jawedhakimi/Hiking_trailer/Mech/Wall mount v3.step

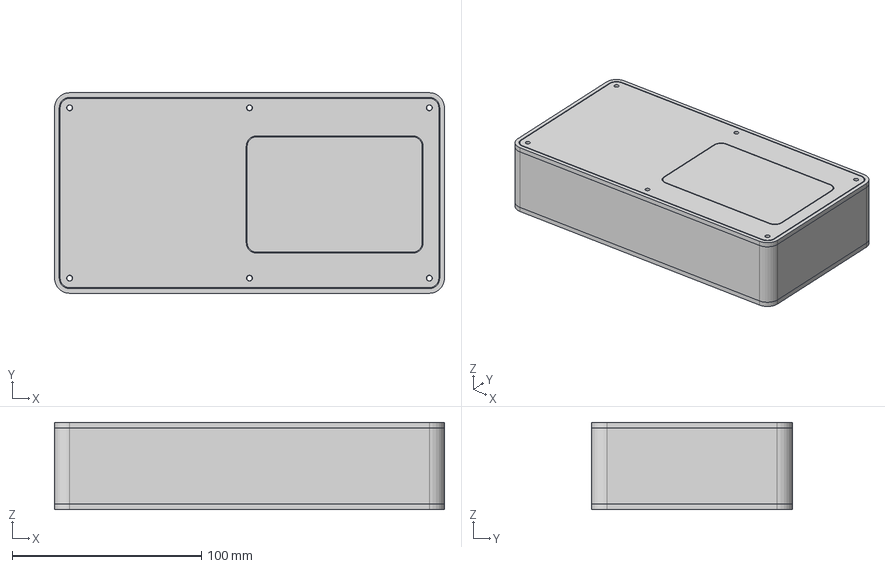
[picture p1: CAD file, 2026-08-29]
Mech/Wall mount v3.step
206.0 x 106.0 x 46.0 mm
3.5inch waveshare display
R_1206 x 4
SOT-223-3_L6.5-W3.4-P2.30-LS7.0-BR
C_0805 x 8
R_0402 x 29
C_0603 x 9
C_1206 x 4
D_SMC
C_0402 x 40
SMAF_L3.5-W2.6-LS4.7-RD
TS-1088-AR02016 x 2
PinHeader_1x03_P2.54mm_Vertical
SM06B-GHS-TB(LF)(SN)--3DModel-STEP-56544 x 3
JST_GH_BM14B-GHS-TBT_1x14-1MP_P1.25mm_Vertical x 2
D_0603 x 5
DFN1006-2L-RD x 4
Q_SOT-23 x 4
ESP32-S3-WROOM-1
SOIC-8_3.9x4.9mm_P1.27mm x 7
SOT-23-3_L2.9-W1.3-P1.90-LS2.4-BL-1
R4875G1_ESP32S3_CAN_Controller 1.80
TYPE-C-SMD_HX-TYPE-C-16PIN
BM08B-GHS-TBT-LF--SN--N---3DModel-STEP-56544 x 2
R4875G1_ESP32S3_CAN_Controller_PCB
Wall mount_1
Face plate
