jawedhakimi/Hiking_trailer/Mech/Face plate.step

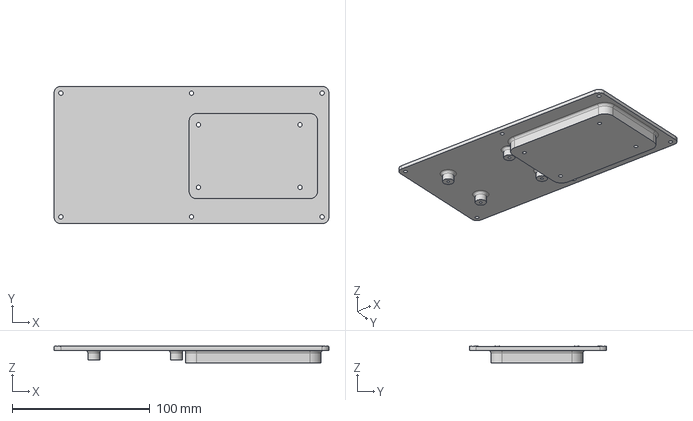
[picture p3: CAD file, 2026-08-29]
Mech/Face plate.step
200.0 x 100.0 x 12.0 mm
