jawedhakimi/Hiking_trailer/Mech/3.5inch waveshare display v4.step

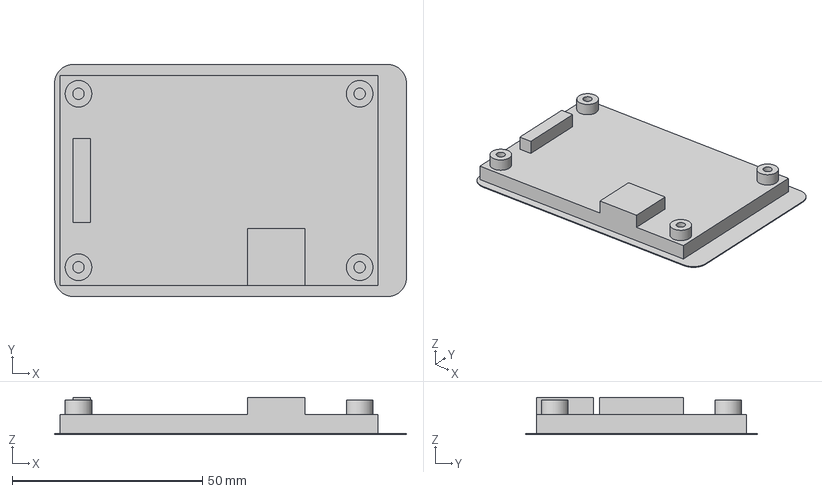
[picture p4: CAD file, 2026-08-29]
Mech/3.5inch waveshare display v4.step
92.4 x 61.0 x 9.80 mm
