jawedhakimi/Hiking_trailer/Mech/Wall mount v2.step

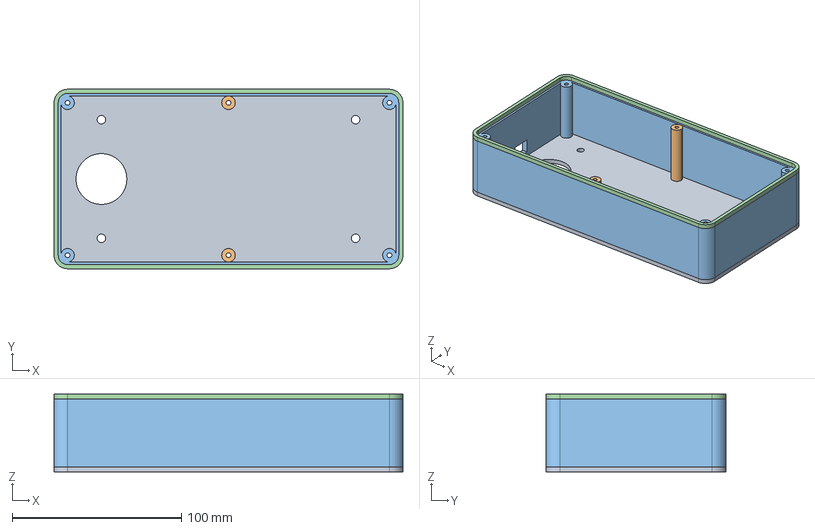
[picture p5: CAD file, 2026-08-29, an earlier design]
Mech/Wall mount v2.step
206.0 x 106.0 x 46.0 mm
