jawedhakimi/Hiking_trailer/HW/ESP32_VESC_Controller.pdf

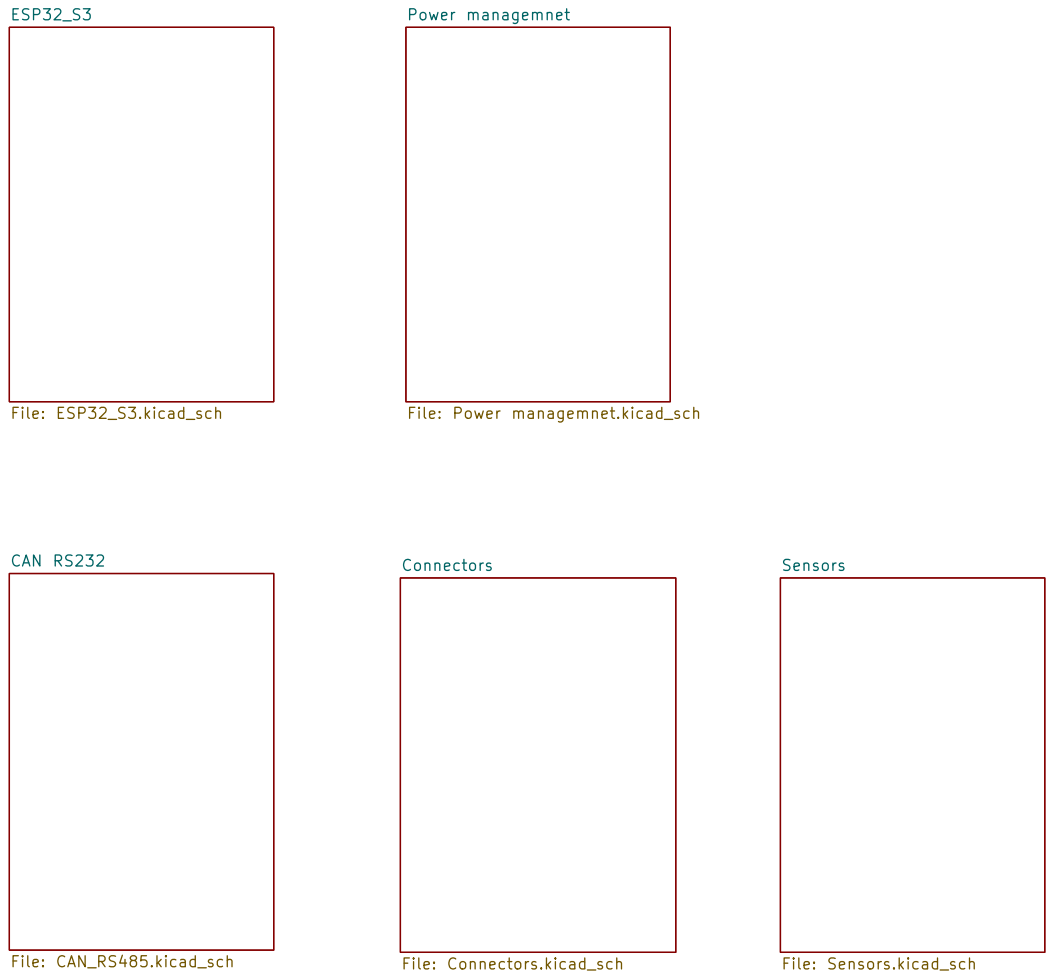
[picture p6: page 1]

Power managemnet File: Power managemnet.kicad_sch

Size: A4 | Rev:
KiCad E.D.A. 10.0.3 | Id: 1/6

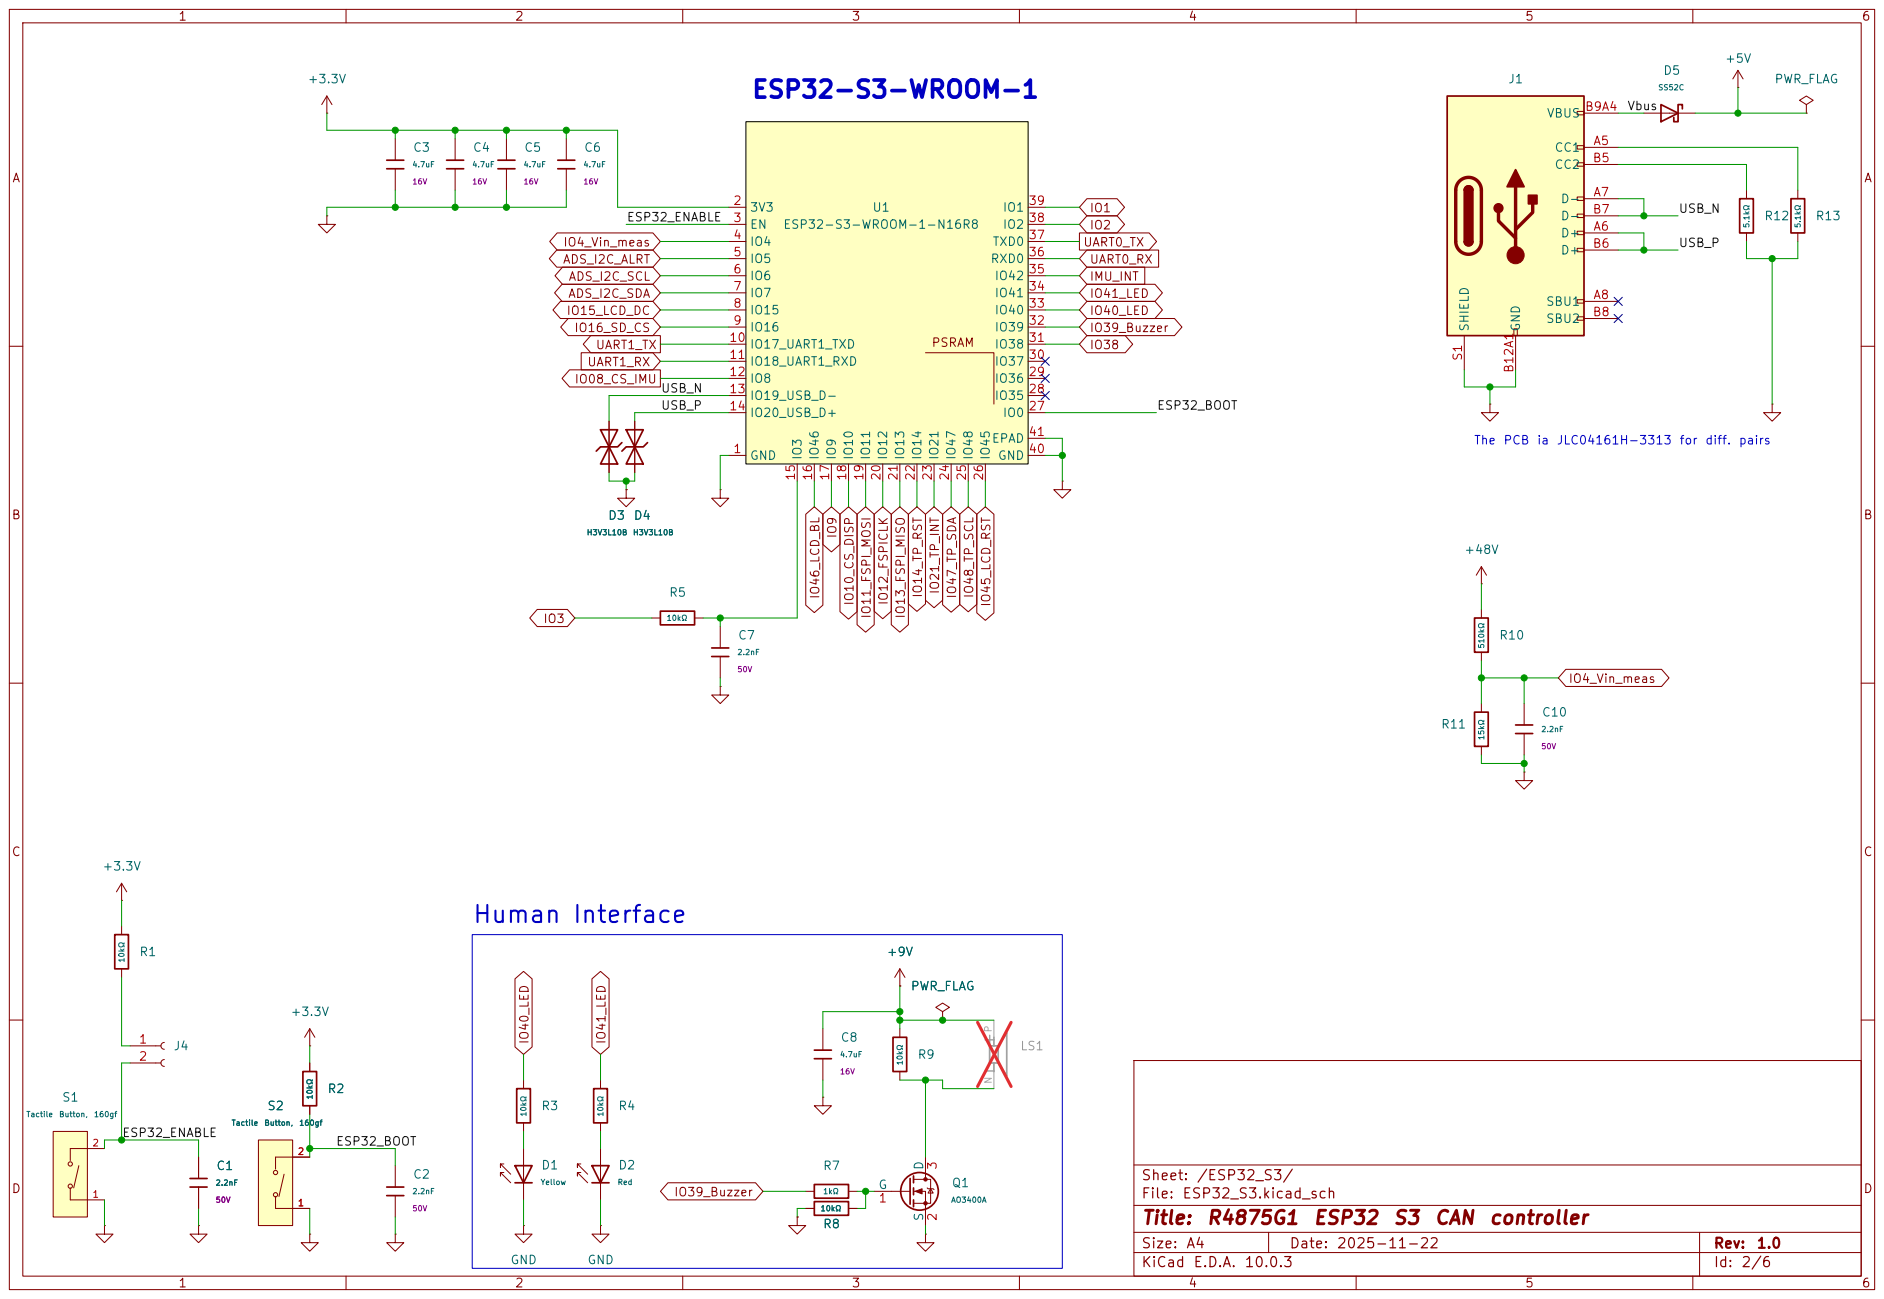
[picture p7: page 2]

The PCB ia JLC04161H-3313 for diff. pairs C1

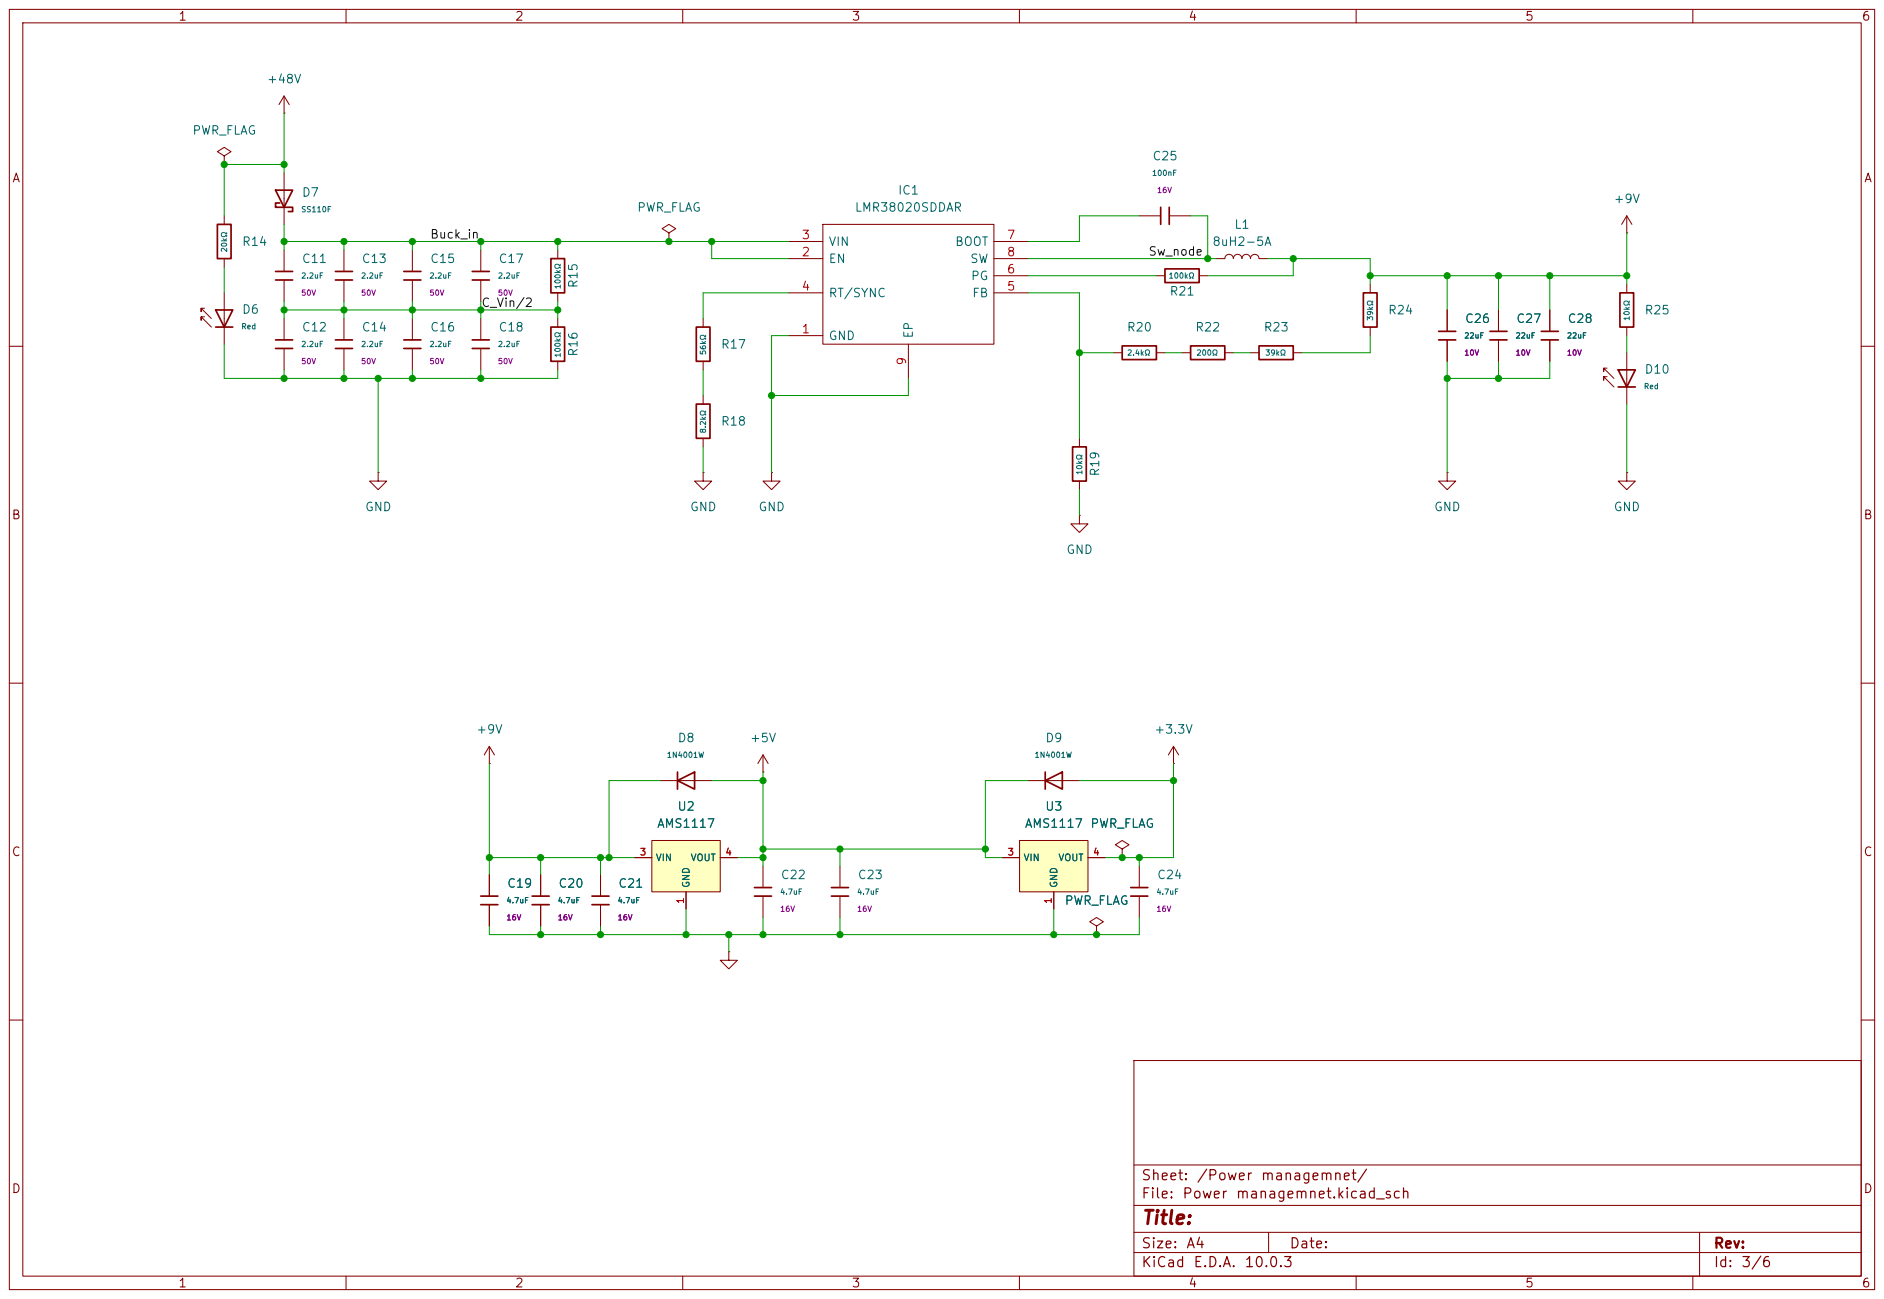
[picture p8: page 3]

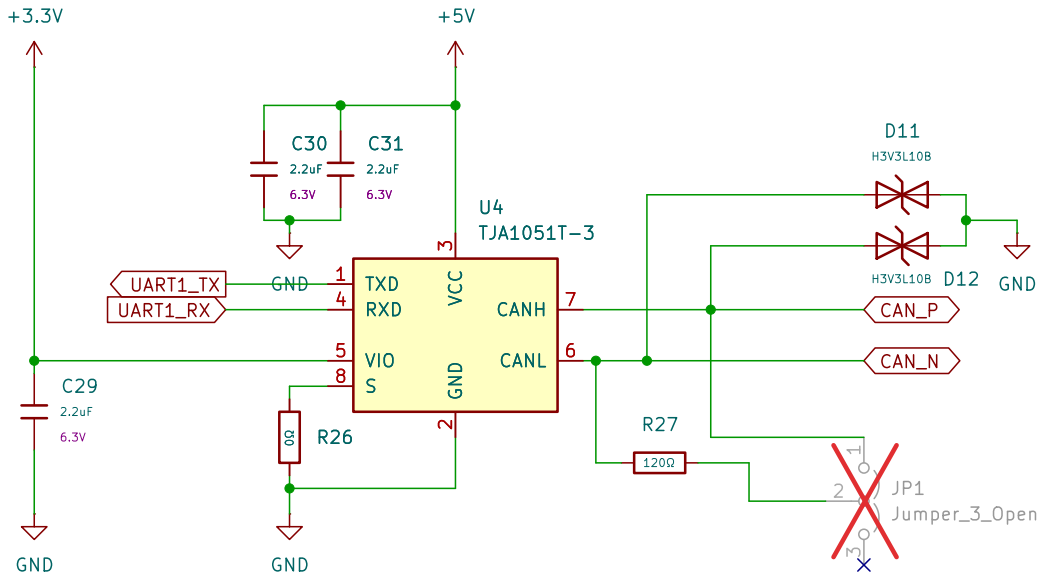
[picture p9: page 4]

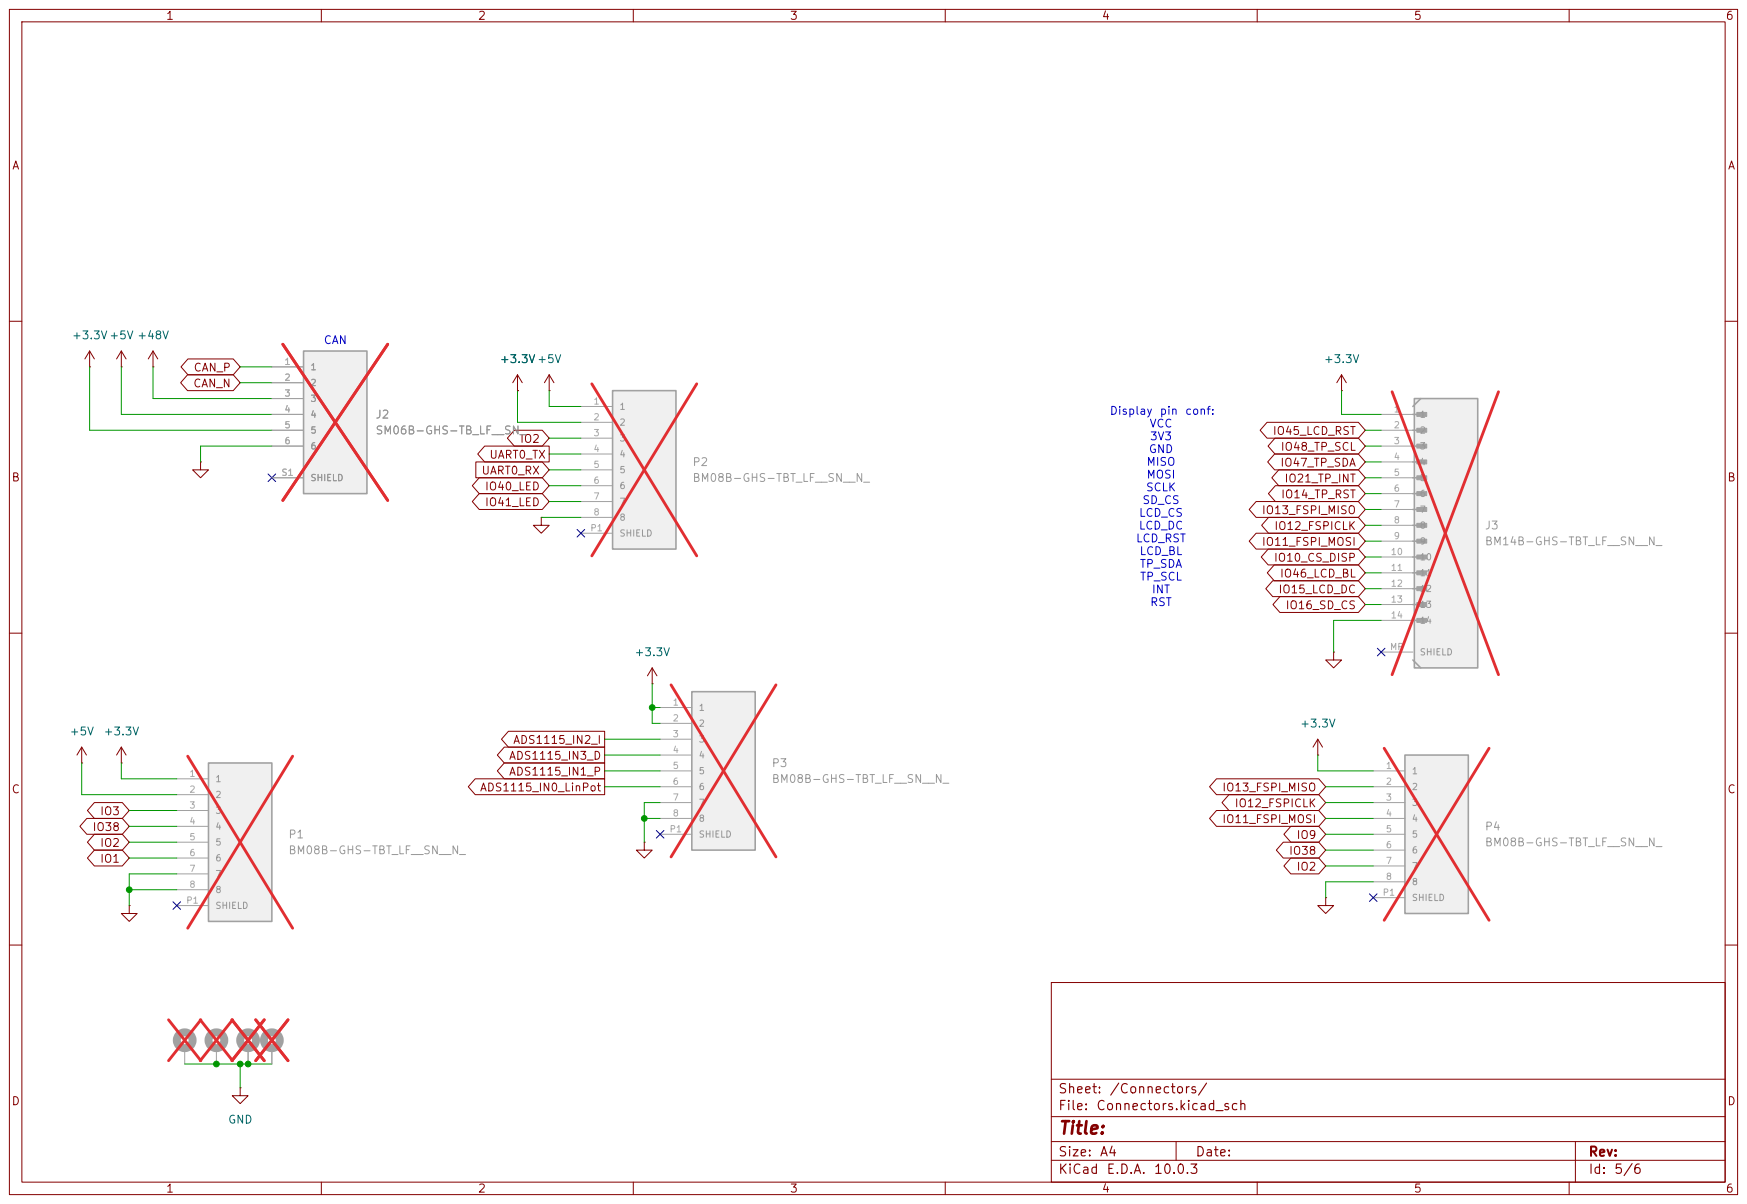
[picture p10: page 5]

IO16_SD_CS Display pin conf: VCC
3V3 GND MISO MOSI SCLK

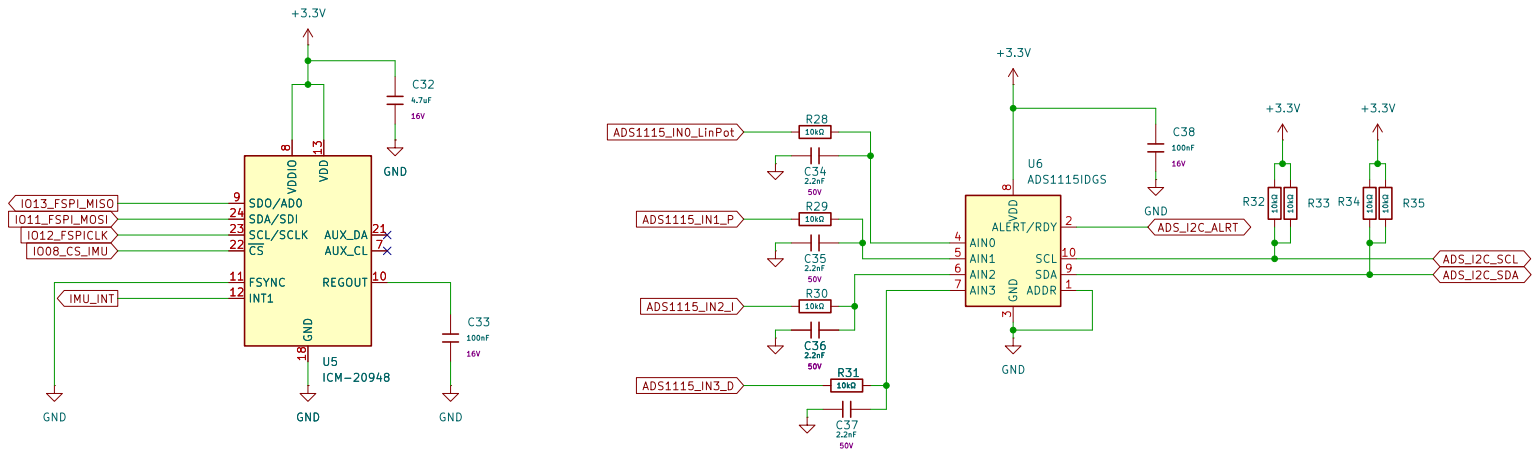
[picture p11: page 6]

AUX_DA 21 CS 22 SCL/SCLK 23 SDA/SDI 24
