jawedhakimi/Hiking_trailer/HW/ESP32_VESC_controller/ESP32_VESC_Controller/ESP32_VESC_Controller.kicad_pcb

## KiCad design HW/ESP32_VESC_controller/ESP32_VESC_Controller/ESP32_VESC_Controller.kicad_pcb (2026-08-29)

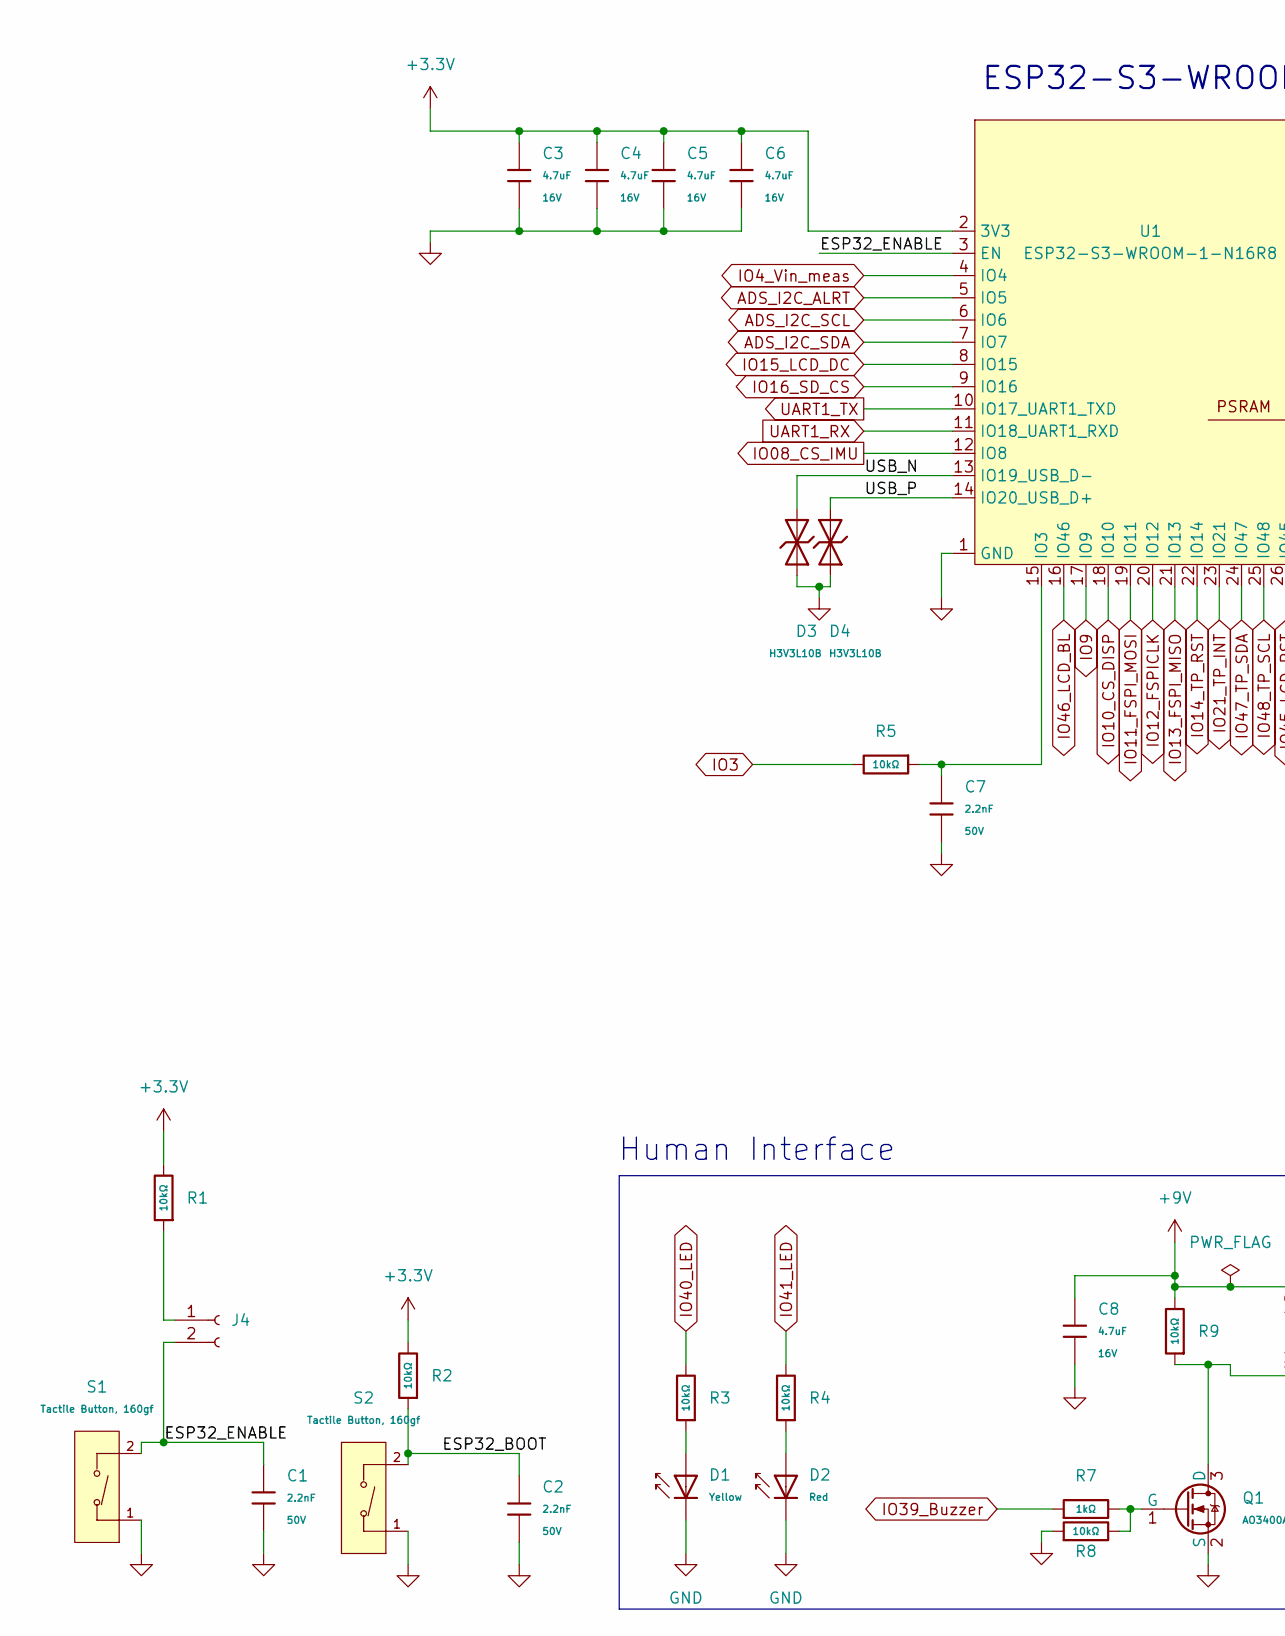
[picture p12: schematic ESP32_S3.kicad_sch, R4875G1 ESP32 S3 CAN controller, part in row 1, column 1]

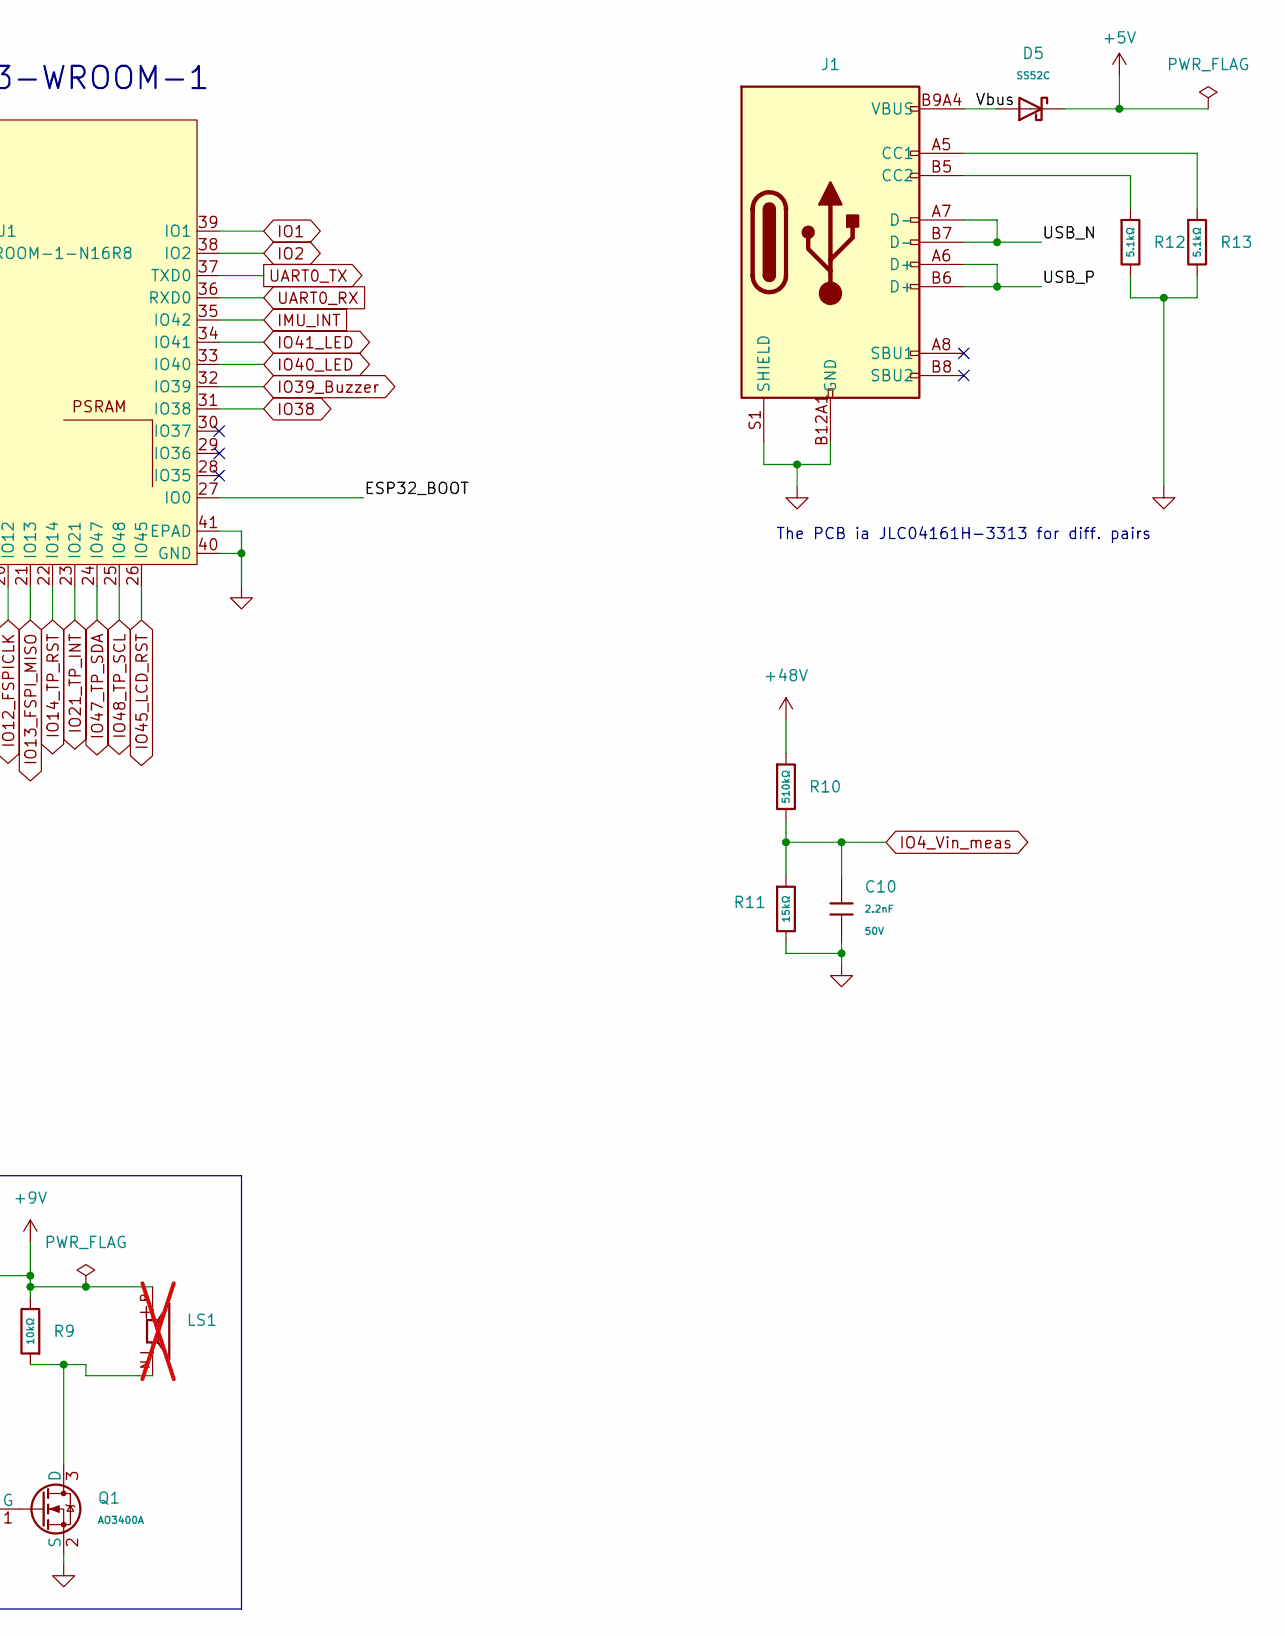
[picture p13: schematic ESP32_S3.kicad_sch, R4875G1 ESP32 S3 CAN controller, part in row 1, column 2]

Parts:
C1, C2, C7, C10: 2.2nF; C_0402; Voltage Rated 50V; Tolerance ±10%; Part 0402B222K500NT; LCSC C1531
C3, C4, C5, C6, C8: 4.7uF; C_0603; Voltage Rated 16V; Tolerance ±10%; Part CL10A475KO8NNNC; LCSC C19666
D1: Yellow; D_0603; Forward Voltage (VF) 1.6V~2.6V; Part NCD0603Y2; LCSC C89811
D2: Red; D_0603; Part KT-0603R; LCSC C2286
D3, D4: H3V3L10B; D_DFN1006-2L; Breakdown Voltage 5.5V; Part H3V3L10B; LCSC C20615781
D5: SS52C; D_SMC; Voltage - Forward(Vf@If) 550mV@5.0A; Voltage - DC Reverse(Vr) 20V; Part SS52C; LCSC C41410784
J1: Connector, USB-TYPE-C-16P; TYPE-C-SMD_HX-TYPE-C-16PIN; LCSC C2927039
J4: Conn_01x02_Socket; PinHeader_1x02_P1.27mm_Vertical
LS1: PKLCS1212E4001-R1; SPKR_PKLCS1212E4001-R1; PARTREV January 22, 2018; not fitted
Q1: AO3400A; Q_SOT-23; Part AO3400A; LCSC C20917
R1, R2, R3, R4, R5, R8, R9: 10kΩ; R_0402; Overload Voltage (Max) 50V; Tolerance ±1%; Part 0402WGF1002TCE; LCSC C25744
R7: 1kΩ; R_0402; Overload Voltage (Max) 50V; Tolerance ±1%; Part 0402WGF1001TCE; LCSC C11702
R10: 510kΩ; R_0402; Overload Voltage (Max) 50V; Tolerance ±1%; Part 0402WGF5103TCE; LCSC C11616
R11: 15kΩ; R_0402; Overload Voltage (Max) 50V; Tolerance ±1%; Part 0402WGF1502TCE; LCSC C25756
R12, R13: 5.1kΩ; R_0402; Overload Voltage (Max) 50V; Tolerance ±1%; Part 0402WGF5101TCE; LCSC C25905
S1, S2: Tactile Button, 160gf; SW_TS-1088-AR02016; Voltage Rating (Dc) 12V; Part TS-1088-AR02016; LCSC C720477
U1: ESP32-S3-WROOM-1-N16R8; ESP32-S3-WROOM-1; JLCPCB Part# C2913202

Connections:
+3.3V: C3.1, C4.1, C5.1, C6.1, R1.2, R2.2, U1.2 (3V3); also elsewhere on the board
+5V: D5.1; also elsewhere on the board
+9V: C8.1, LS1.P, R9.2; also elsewhere on the board
+48V: R10.1; also elsewhere on the board
/ESP32_S3/ESP32_BOOT: C2.1, R2.1, S2.2 (B), U1.27 (IO0)
/ESP32_S3/ESP32_ENABLE: C1.1, J4.2, S1.2 (B), U1.3 (EN)
/ESP32_S3/USB_N: D3.1, J1.A7 (D-), J1.B7 (D-), U1.13 (IO19_USB_D-)
/ESP32_S3/USB_P: D4.2, J1.A6 (D+), J1.B6 (D+), U1.14 (IO20_USB_D+)
/ESP32_S3/Vbus: D5.2, J1.A9B4 (VBUS), J1.B9A4 (VBUS)
ADS_I2C_ALRT: U1.5 (IO5); also elsewhere on the board
ADS_I2C_SCL: U1.6 (IO6); also elsewhere on the board
ADS_I2C_SDA: U1.7 (IO7); also elsewhere on the board
GND: C1.2, C2.2, C3.2, C4.2, C5.2, C6.2, C7.2, C8.2, C10.2, D1.1, D2.1, D3.2, D4.1, J1.A12B1 (GND), J1.B12A1 (GND), J1.S1 (SHIELD), Q1.2 (S), R8.1, R11.2, R12.2, R13.2, S1.1 (A), S2.1 (A), U1.1 (GND), U1.40 (GND), U1.41 (EPAD); also elsewhere on the board
IMU_INT: U1.35 (IO42); also elsewhere on the board
IO1: U1.39 (IO1); also elsewhere on the board
IO2: U1.38 (IO2); also elsewhere on the board
IO3: R5.2; also elsewhere on the board
IO4_Vin_meas: C10.1, R10.2, R11.1, U1.4 (IO4)
IO08_CS_IMU: U1.12 (IO8); also elsewhere on the board
IO9: U1.17 (IO9); also elsewhere on the board
IO10_CS_DISP: U1.18 (IO10); also elsewhere on the board
IO11_FSPI_MOSI: U1.19 (IO11); also elsewhere on the board
IO12_FSPICLK: U1.20 (IO12); also elsewhere on the board
IO13_FSPI_MISO: U1.21 (IO13); also elsewhere on the board
IO14_TP_RST: U1.22 (IO14); also elsewhere on the board
IO15_LCD_DC: U1.8 (IO15); also elsewhere on the board
IO16_SD_CS: U1.9 (IO16); also elsewhere on the board
IO21_TP_INT: U1.23 (IO21); also elsewhere on the board
IO38: U1.31 (IO38); also elsewhere on the board
IO39_Buzzer: R7.1, U1.32 (IO39)
IO40_LED: R3.2, U1.33 (IO40); also elsewhere on the board
IO41_LED: R4.2, U1.34 (IO41); also elsewhere on the board
IO45_LCD_RST: U1.26 (IO45); also elsewhere on the board
IO46_LCD_BL: U1.16 (IO46); also elsewhere on the board
IO47_TP_SDA: U1.24 (IO47); also elsewhere on the board
IO48_TP_SCL: U1.25 (IO48); also elsewhere on the board
unnamed: D1.2, R3.1
unnamed: D2.2, R4.1
unnamed: J1.A5 (CC1), R13.1
unnamed: J1.B5 (CC2), R12.1
unnamed: J4.1, R1.1
unnamed: LS1.N, Q1.3 (D), R9.1
unnamed: Q1.1 (G), R7.2, R8.2
unnamed: C7.1, R5.1, U1.15 (IO3)
UART0_RX: U1.36 (RXD0); also elsewhere on the board
UART0_TX: U1.37 (TXD0); also elsewhere on the board
UART1_RX: U1.11 (IO18_UART1_RXD); also elsewhere on the board
UART1_TX: U1.10 (IO17_UART1_TXD); also elsewhere on the board

Notes on the sheet:
Human Interface
ESP32-S3-WROOM-1
The PCB ia JLC04161H-3313 for diff. pairs

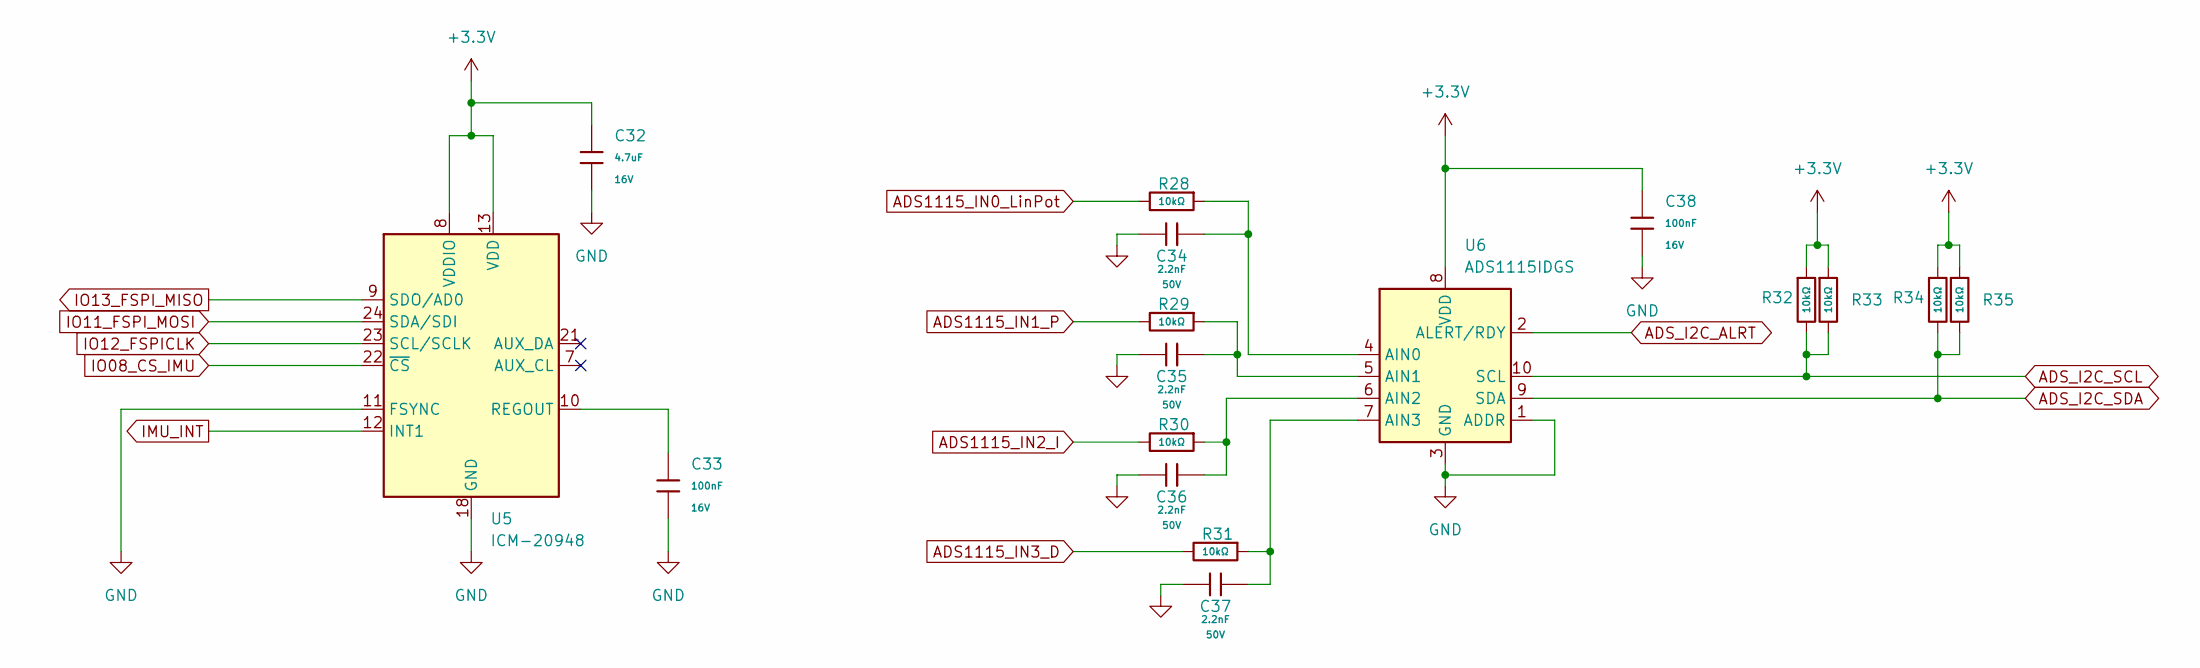
[picture p14: schematic Sensors.kicad_sch]

Parts:
C32: 4.7uF; C_0603; Voltage Rated 16V; Tolerance ±10%; Part CL10A475KO8NNNC; LCSC C19666
C33, C38: 100nF; C_0402; Voltage Rated 16V; Tolerance ±10%; Part CL05B104KO5NNNC; LCSC C1525
C34, C35, C36, C37: 2.2nF; C_0402; Voltage Rated 50V; Tolerance ±10%; Part 0402B222K500NT; LCSC C1531
R28, R29, R30, R31, R32, R33, R34, R35: 10kΩ; R_0402; Overload Voltage (Max) 50V; Tolerance ±1%; Part 0402WGF1002TCE; LCSC C25744
U5: ICM-20948; InvenSense_QFN-24_3x3mm_P0.4mm
U6: ADS1115IDGS; TSSOP-10_3x3mm_P0.5mm

Connections:
+3.3V: C32.1, C38.1, R32.1, R33.1, R34.1, R35.1, U5.8 (VDDIO), U5.13 (VDD), U6.8 (VDD); also elsewhere on the board
ADS1115_IN0_LinPot: R28.2; also elsewhere on the board
ADS1115_IN1_P: R29.2; also elsewhere on the board
ADS1115_IN2_I: R30.2; also elsewhere on the board
ADS1115_IN3_D: R31.2; also elsewhere on the board
ADS_I2C_ALRT: U6.2 (ALERT/RDY); also elsewhere on the board
ADS_I2C_SCL: R32.2, R33.2, U6.10 (SCL); also elsewhere on the board
ADS_I2C_SDA: R34.2, R35.2, U6.9 (SDA); also elsewhere on the board
GND: C32.2, C33.2, C34.2, C35.2, C36.2, C37.2, C38.2, U5.11 (FSYNC), U5.18 (GND), U5.20 (GND), U6.1 (ADDR), U6.3 (GND); also elsewhere on the board
IMU_INT: U5.12 (INT1); also elsewhere on the board
IO08_CS_IMU: U5.22 (~CS); also elsewhere on the board
IO11_FSPI_MOSI: U5.24 (SDA/SDI); also elsewhere on the board
IO12_FSPICLK: U5.23 (SCL/SCLK); also elsewhere on the board
IO13_FSPI_MISO: U5.9 (SDO/AD0); also elsewhere on the board
unnamed: C33.1, U5.10 (REGOUT)
unnamed: C34.1, R28.1, U6.4 (AIN0)
unnamed: C35.1, R29.1, U6.5 (AIN1)
unnamed: C36.1, R30.1, U6.6 (AIN2)
unnamed: C37.1, R31.1, U6.7 (AIN3)

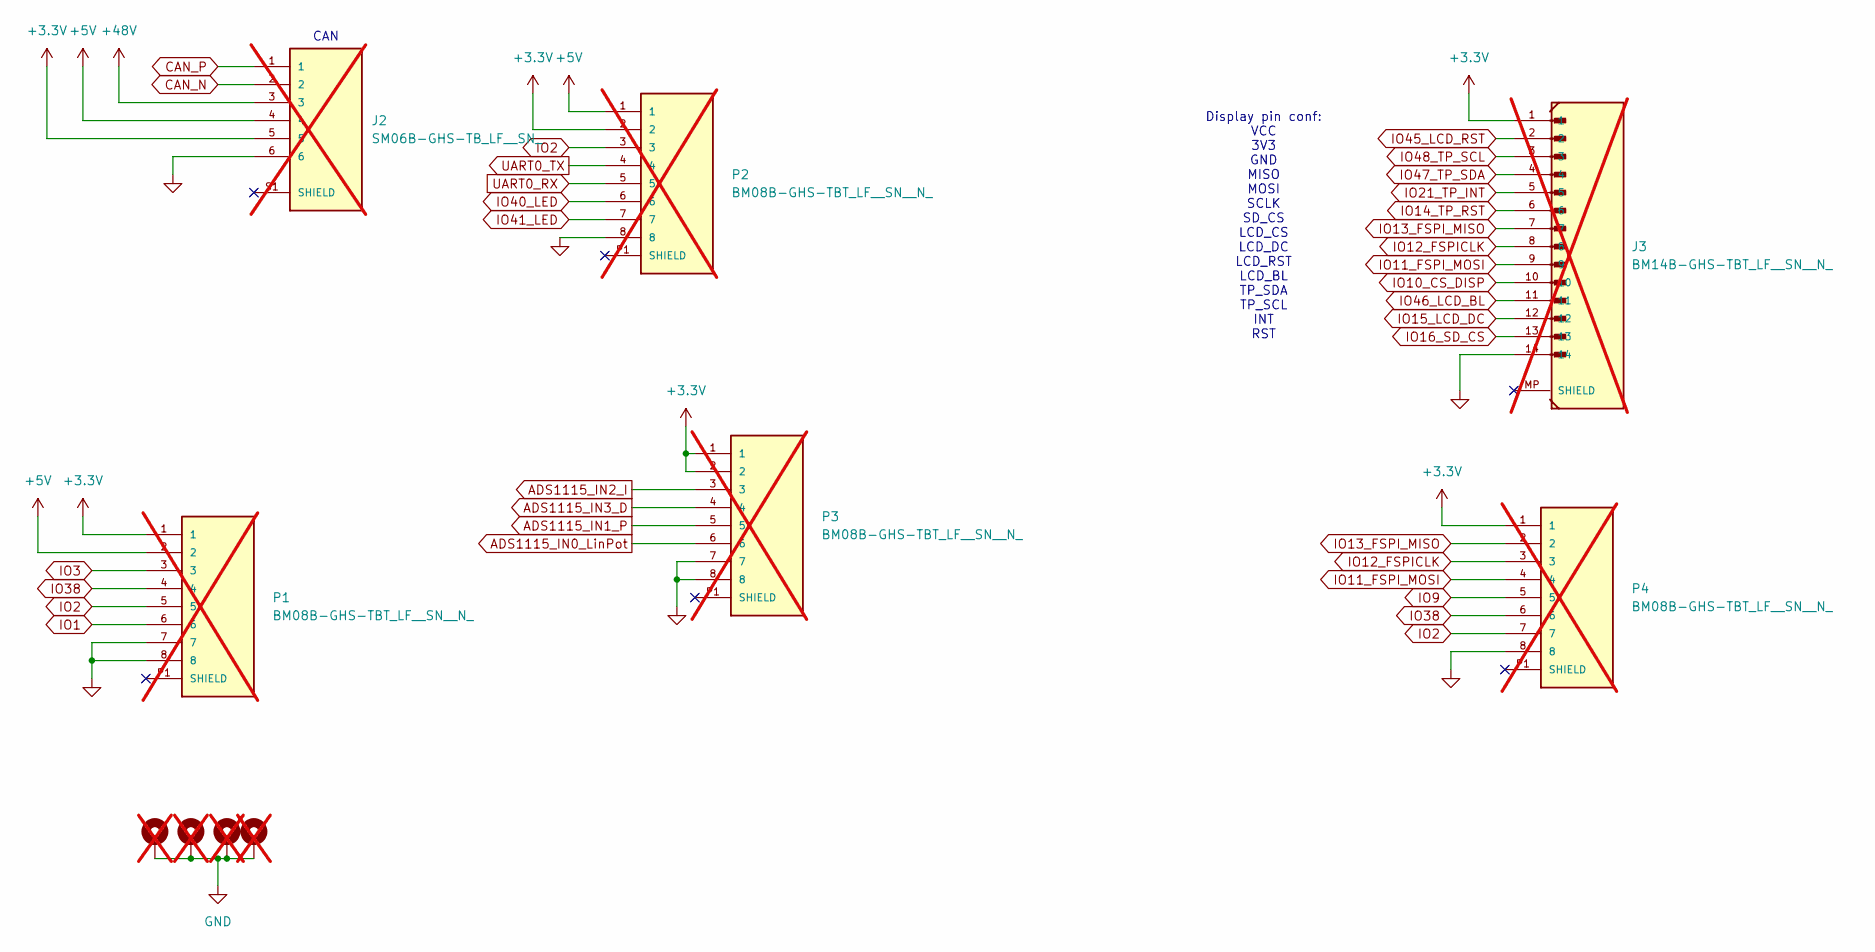
[picture p15: schematic Connectors.kicad_sch]

Parts:
H1, H2, H3, H4: MountingHole_Pad; MountingHole_2.7mm_M2.5_Pad; not fitted
J2: SM06B-GHS-TB_LF__SN_; JST_SM06B-GHS-TB_LF__SN_; PARTREV N/A; not fitted
J3: BM14B-GHS-TBT_LF__SN__N_; JST_GH_BM14B-GHS-TBT_1x14-1MP_P1.25mm_Vertical; PARTREV N/A; not fitted
P1, P2, P3, P4: BM08B-GHS-TBT_LF__SN__N_; JST_BM08B-GHS-TBT_LF__SN__N_; not fitted

Connections:
+3.3V: J2.5, J3.1, P1.1, P2.2, P3.1, P3.2, P4.1; also elsewhere on the board
+5V: J2.4, P1.2, P2.1; also elsewhere on the board
+48V: J2.3; also elsewhere on the board
ADS1115_IN0_LinPot: P3.6; also elsewhere on the board
ADS1115_IN1_P: P3.5; also elsewhere on the board
ADS1115_IN2_I: P3.3; also elsewhere on the board
ADS1115_IN3_D: P3.4; also elsewhere on the board
CAN_N: J2.2; also elsewhere on the board
CAN_P: J2.1; also elsewhere on the board
GND: H1.1 (1_1), H2.1 (1_1), H3.1 (1_1), H4.1 (1_1), J2.6, J3.14, P1.7, P1.8, P2.8, P3.7, P3.8, P4.8; also elsewhere on the board
IO1: P1.6; also elsewhere on the board
IO2: P1.5, P2.3, P4.7; also elsewhere on the board
IO3: P1.3; also elsewhere on the board
IO9: P4.5; also elsewhere on the board
IO10_CS_DISP: J3.10; also elsewhere on the board
IO11_FSPI_MOSI: J3.9, P4.4; also elsewhere on the board
IO12_FSPICLK: J3.8, P4.3; also elsewhere on the board
IO13_FSPI_MISO: J3.7, P4.2; also elsewhere on the board
IO14_TP_RST: J3.6; also elsewhere on the board
IO15_LCD_DC: J3.12; also elsewhere on the board
IO16_SD_CS: J3.13; also elsewhere on the board
IO21_TP_INT: J3.5; also elsewhere on the board
IO38: P1.4, P4.6; also elsewhere on the board
IO40_LED: P2.6; also elsewhere on the board
IO41_LED: P2.7; also elsewhere on the board
IO45_LCD_RST: J3.2; also elsewhere on the board
IO46_LCD_BL: J3.11; also elsewhere on the board
IO47_TP_SDA: J3.4; also elsewhere on the board
IO48_TP_SCL: J3.3; also elsewhere on the board
UART0_RX: P2.5; also elsewhere on the board
UART0_TX: P2.4; also elsewhere on the board

Notes on the sheet:
Display pin conf: VCC 3V3 GND MISO MOSI SCLK SD_CS LCD_CS LCD_DC LCD_RST LCD_BL TP_SDA TP_SCL INT RST
CAN

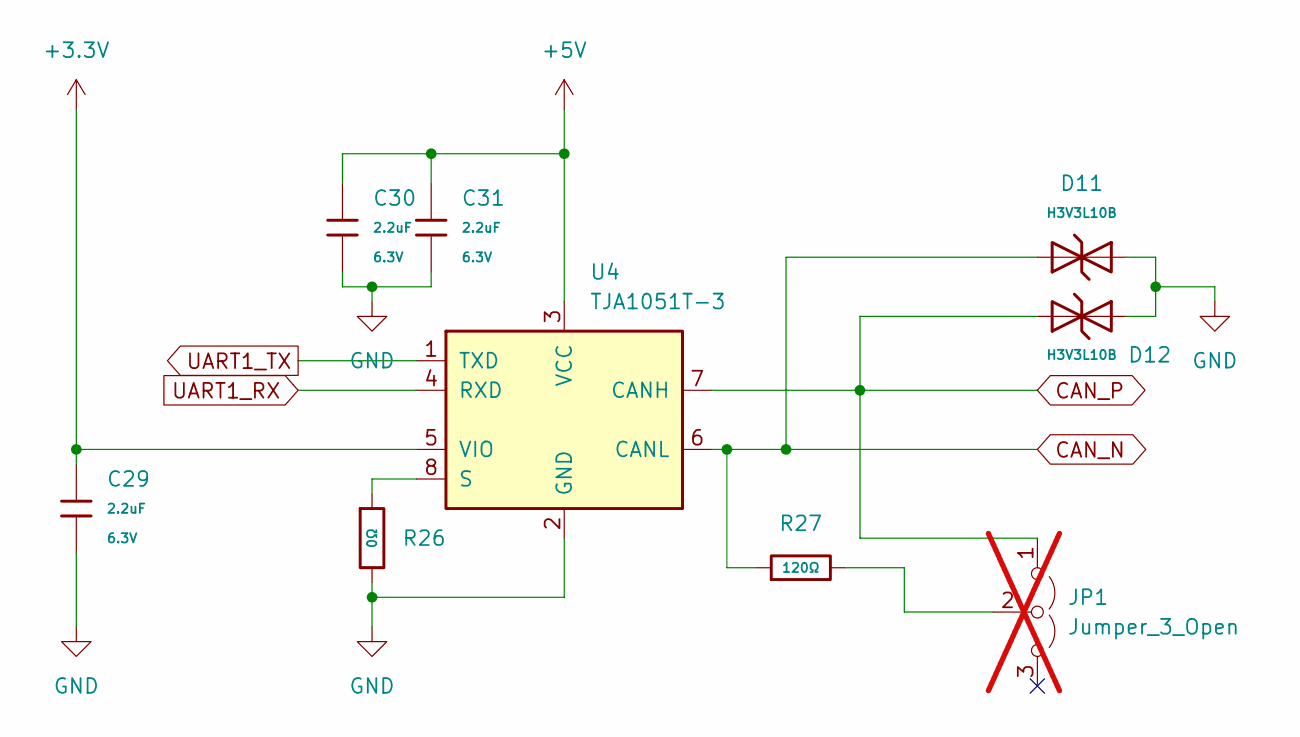
[picture p16: schematic CAN_RS485.kicad_sch]

Parts:
C29, C30, C31: 2.2uF; C_0402; Voltage Rated 6.3V; Tolerance ±20%; Part CL05A225MQ5NSNC; LCSC C12530
D11, D12: H3V3L10B; D_DFN1006-2L; Breakdown Voltage 5.5V; Part H3V3L10B; LCSC C20615781
JP1: Jumper_3_Open; SolderJumper-3_P1.3mm_Open_RoundedPad1.0x1.5mm_NumberLabels; not fitted
R26: 0Ω; R_0402; Overload Voltage (Max) 50V; Tolerance ±1%; Part 0402WGF0000TCE; LCSC C17168
R27: 120Ω; R_1206; Overload Voltage (Max) 200V; Tolerance ±1%; Part 1206W4F1200T5E; LCSC C17909
U4: TJA1051T-3; SOIC-8_3.9x4.9mm_P1.27mm

Connections:
+3.3V: C29.1, U4.5 (VIO); also elsewhere on the board
+5V: C30.1, C31.1, U4.3 (VCC); also elsewhere on the board
CAN_N: D11.2, R27.1, U4.6 (CANL); also elsewhere on the board
CAN_P: D12.1, JP1.1 (A), U4.7 (CANH); also elsewhere on the board
GND: C29.2, C30.2, C31.2, D11.1, D12.2, R26.2, U4.2 (GND); also elsewhere on the board
unnamed: JP1.2 (C), R27.2
unnamed: R26.1, U4.8 (S)
UART1_RX: U4.4 (RXD); also elsewhere on the board
UART1_TX: U4.1 (TXD); also elsewhere on the board

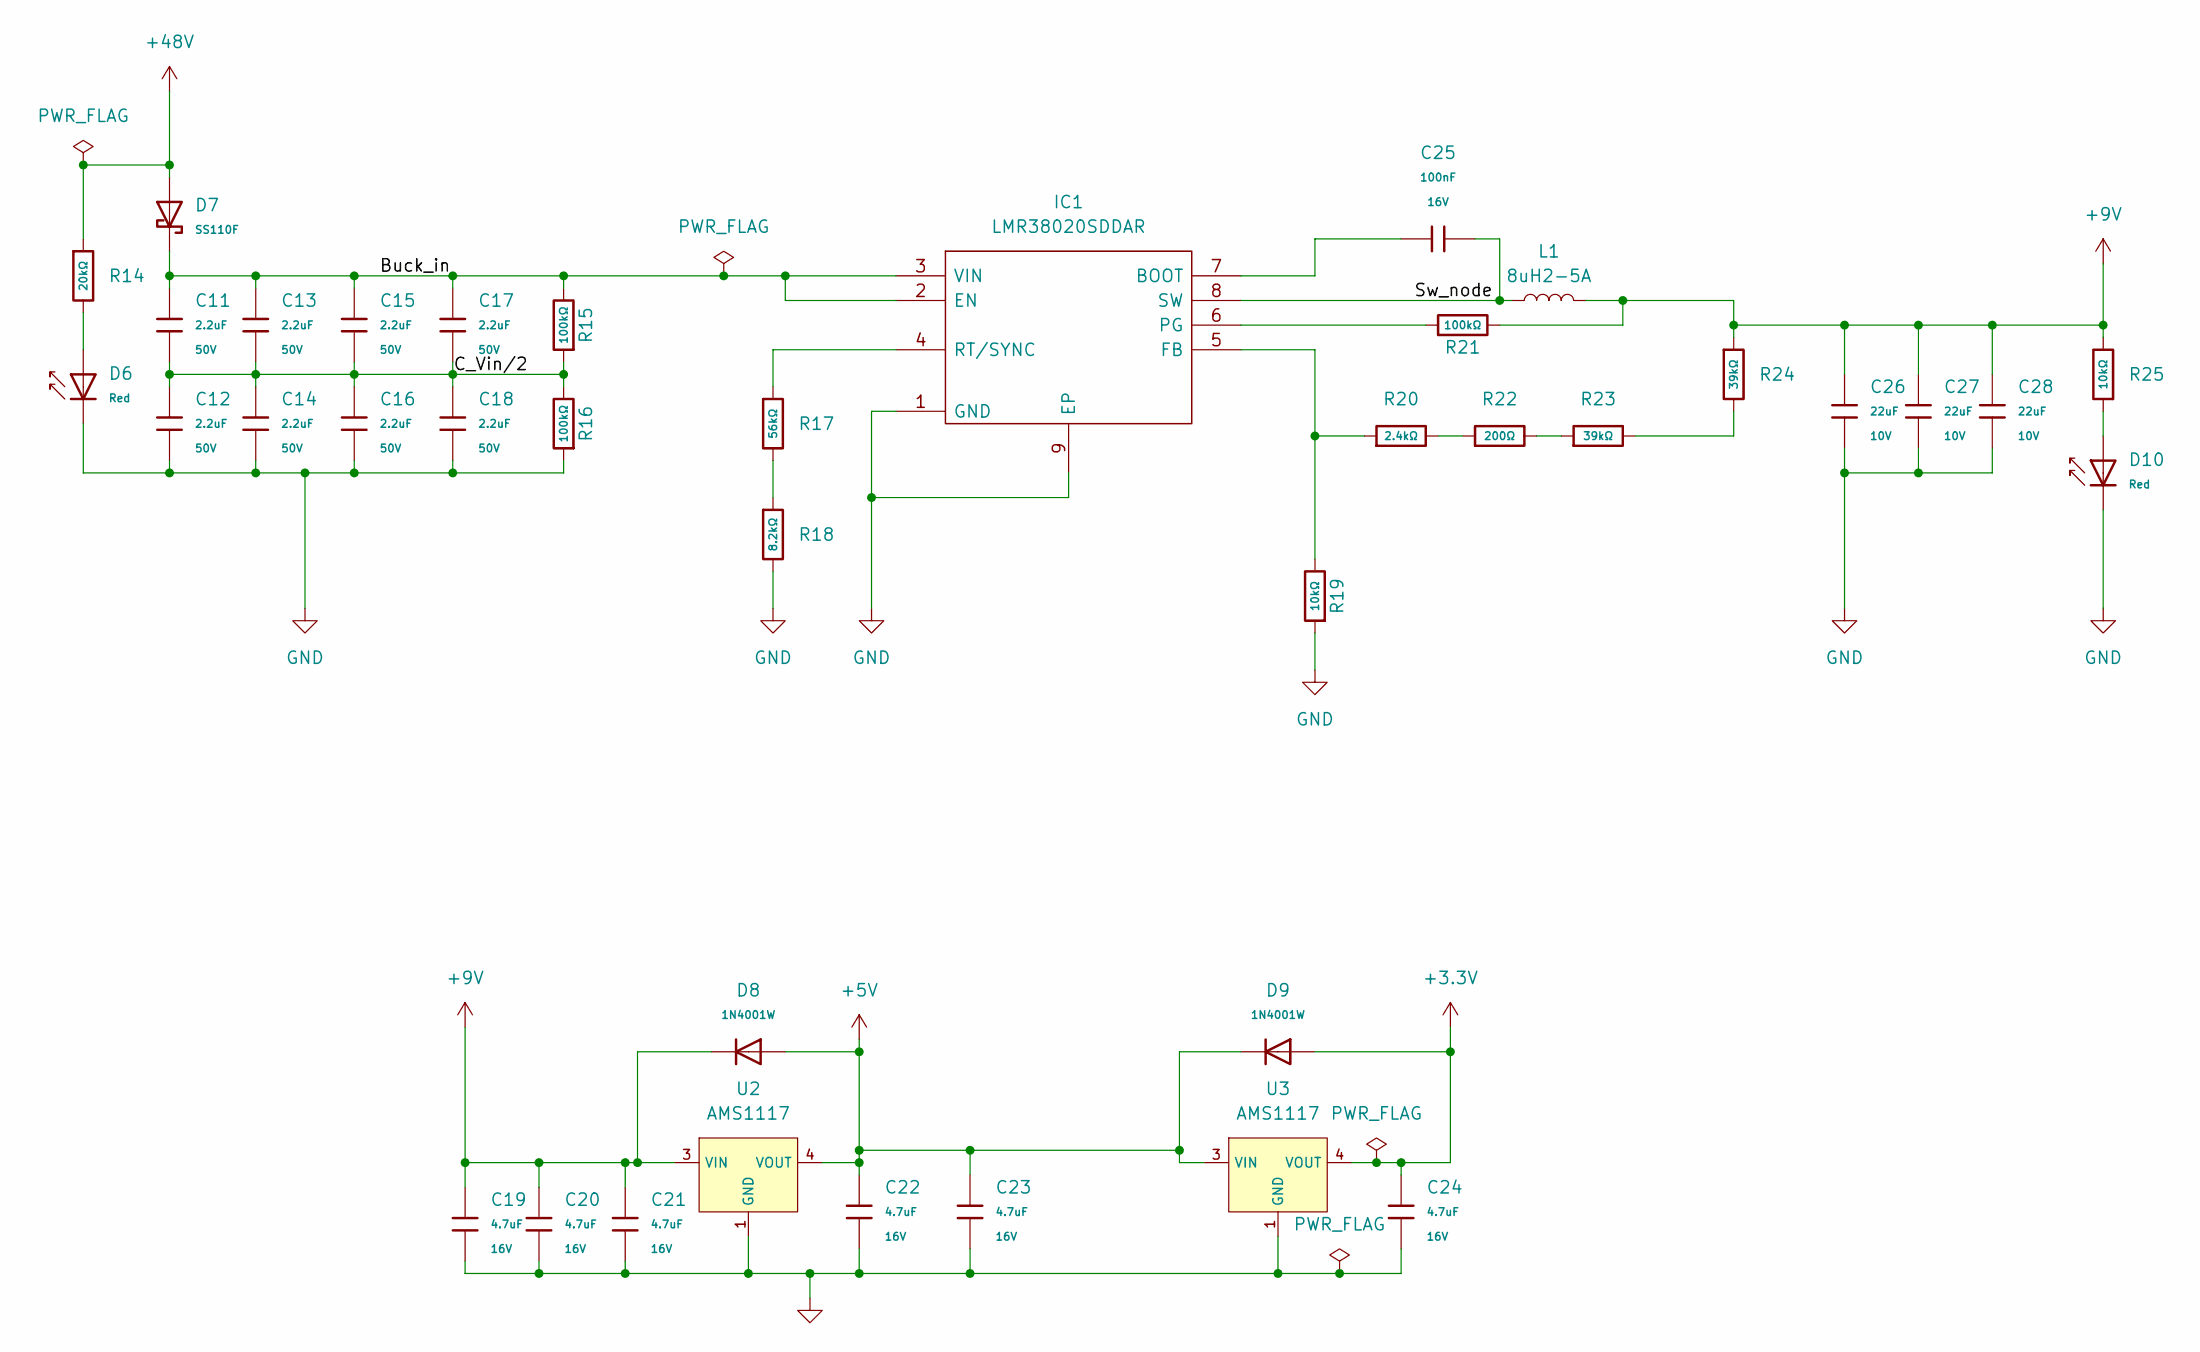
[picture p17: schematic Power managemnet.kicad_sch]

Parts:
C11, C12, C13, C14, C15, C16, C17, C18: 2.2uF; C_0805; Voltage Rated 50V; Tolerance ±10%; Part CL21A225KBQNNNE; LCSC C377773
C19, C20, C21, C22, C23, C24: 4.7uF; C_0603; Voltage Rated 16V; Tolerance ±10%; Part CL10A475KO8NNNC; LCSC C19666
C25: 100nF; C_0402; Voltage Rated 16V; Tolerance ±10%; Part CL05B104KO5NNNC; LCSC C1525
C26, C27, C28: 22uF; C_1206; Voltage Rated 10V; Tolerance ±10%; Part CL31A226KPHNNNE; LCSC C5672
D6, D10: Red; D_0603; Part KT-0603R; LCSC C2286
D7: SS110F; D_SMAF; Forward Voltage (Vf@If) 850mV@1A; Reverse Voltage (Vr) 100V; Part SS110F; LCSC C41411770
D8, D9: 1N4001W; D_SOD-123FL; Voltage - Forward(Vf@If) 1V@1.0A; Voltage - DC Reverse(Vr) 50V; Part 1N4001W; LCSC C18199085
IC1: LMR38020SDDAR; SOIC127P600X170-9N; Manufacturer_Part_Number LMR38020SDDAR; Mouser Part Number 595-LMR38020SDDAR
L1: 8uH2-5A; IND-SMD_L6.0-W6.0; JLCPCB Part# C167222
R14: 20kΩ; R_0402; Overload Voltage (Max) 50V; Tolerance ±1%; Part 0402WGF2002TCE; LCSC C25765
R15, R16, R21: 100kΩ; R_0402; Overload Voltage (Max) 50V; Tolerance ±1%; Part 0402WGF1003TCE; LCSC C25741
R17: 56kΩ; R_0402; Overload Voltage (Max) 50V; Tolerance ±1%; Part 0402WGF5602TCE; LCSC C25796
R18: 8.2kΩ; R_0402; Overload Voltage (Max) 50V; Tolerance ±1%; Part 0402WGF8201TCE; LCSC C25924
R19, R25: 10kΩ; R_0402; Overload Voltage (Max) 50V; Tolerance ±1%; Part 0402WGF1002TCE; LCSC C25744
R20: 2.4kΩ; R_0402; Overload Voltage (Max) 50V; Tolerance ±1%; Part 0402WGF2401TCE; LCSC C25882
R22: 200Ω; R_0402; Overload Voltage (Max) 50V; Tolerance ±1%; Part 0402WGF2000TCE; LCSC C25087
R23, R24: 39kΩ; R_0402; Overload Voltage (Max) 50V; Tolerance ±1%; Part 0402WGF3902TCE; LCSC C25783
U2: AMS1117; SOT-223_L6.5-W3.5-P2.30-LS7.0-BR; Output Voltage 5V; Dropout Voltage 1.3V@(1A); Part AMS1117-5.0; LCSC C6187
U3: AMS1117; SOT-223-3_L6.5-W3.4-P2.30-LS7.0-BR; Output Voltage 3.3V; Dropout Voltage 1.3V@(800mA); Part AMS1117-3.3; LCSC C6186

Connections:
+3.3V: C24.1, D9.2, U3.2 (VOUT), U3.4 (VOUT); also elsewhere on the board
+5V: C22.1, C23.1, D8.2, D9.1, U2.2 (VOUT), U2.4 (VOUT), U3.3 (VIN); also elsewhere on the board
+9V: C19.1, C20.1, C21.1, C26.1, C27.1, C28.1, D8.1, L1.2, R21.2, R24.1, R25.2, U2.3 (VIN); also elsewhere on the board
+48V: D7.2, R14.1; also elsewhere on the board
/Power managemnet/Buck_in: C11.1, C13.1, C15.1, C17.1, D7.1, IC1.2 (EN), IC1.3 (VIN), R15.2
/Power managemnet/C_Vin/2: C11.2, C12.1, C13.2, C14.1, C15.2, C16.1, C17.2, C18.1, R15.1, R16.2
/Power managemnet/Sw_node: C25.2, IC1.8 (SW), L1.1
GND: C12.2, C14.2, C16.2, C18.2, C19.2, C20.2, C21.2, C22.2, C23.2, C24.2, C26.2, C27.2, C28.2, D6.1, D10.1, IC1.1 (GND), IC1.9 (EP), R16.1, R18.2, R19.1, U2.1 (GND), U3.1 (GND); also elsewhere on the board
unnamed: D6.2, R14.2
unnamed: D10.2, R25.1
unnamed: C25.1, IC1.7 (BOOT)
unnamed: IC1.5 (FB), R19.2, R20.1
unnamed: IC1.6 (PG), R21.1
unnamed: IC1.4 (RT/SYNC), R17.1
unnamed: R17.2, R18.1
unnamed: R20.2, R22.1
unnamed: R22.2, R23.1
unnamed: R23.2, R24.2

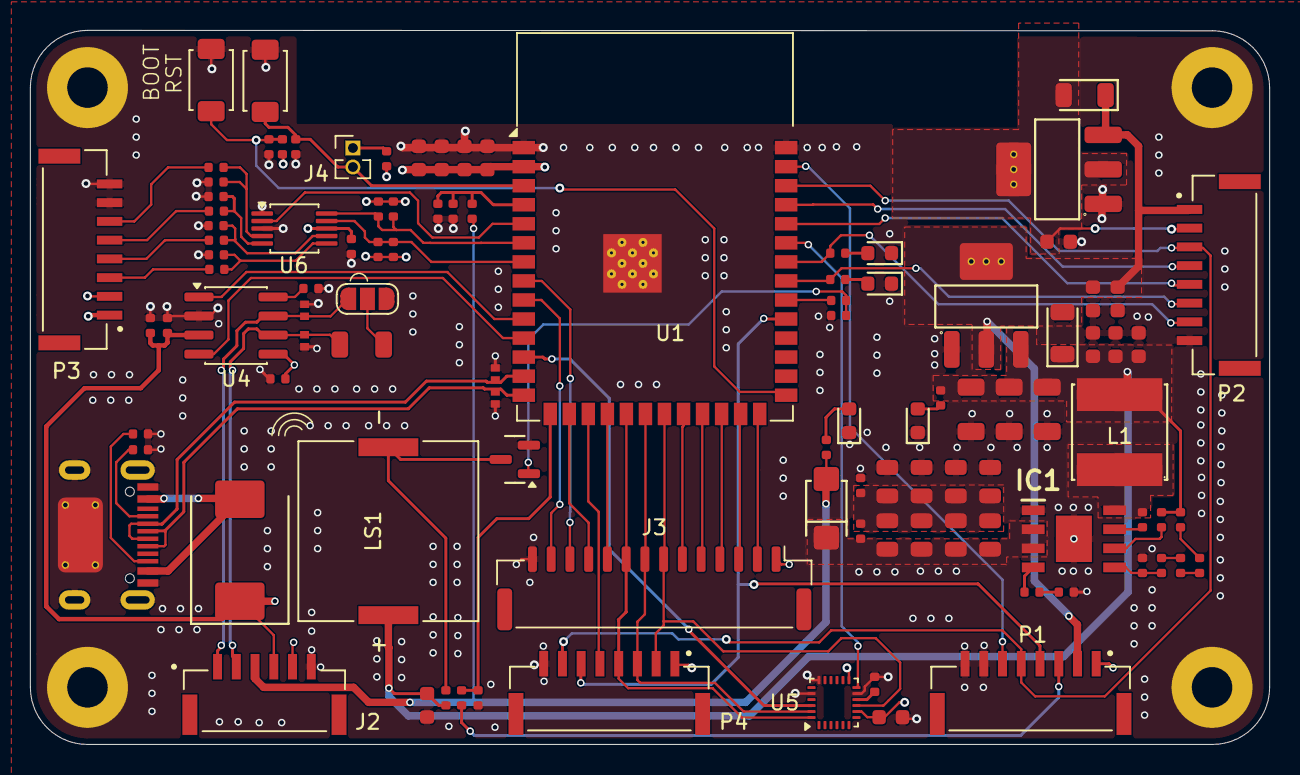
[picture p18: board ESP32_VESC_Controller.kicad_pcb from above]

Board: 4 copper layers, 82.6 x 47.6 mm, 108 parts (0 on the bottom side), 74 nets.
